1900helloword/HandBridge-SG90/Docs/PCB/BOM_Board1_PCB1_2026-09-20.xlsx

No. | Quantity | Comment | Designator | Footprint | Value | Manufacturer Part | Manufacturer | Supplier Part | Supplier
1 | 2 | 10uF | C1,C6 | C0603 | 10uF
2 | 1 | 106pF | C2 | C0603 | 106pF
3 | 1 | 104pF | C3 | C0603 | 104pF
4 | 1 | 223pF | C4 | C0603 | 223pF
5 | 1 | 105pF | C5 | C0603 | 105pF
6 | 1 | 220uF | C7 | C_Ele_SMD_3x5.4mm | 220uF
7 | 1 | 100nF | C8 | C0603 | 100nF
8 | 1 | 104pF | C25 | C0402 | 104pF
9 | 2 | 20pF | C33,C34 | C0805 | 20pF
10 | 3 | PH2.54-1X10P-H25 | H1,H2,H3 | HDR-TH_10P-P2.54-V-M |  | PH2.54-1X10P-H25 | JXTCONN(聚兴泰) | C42431810 | LCSC
11 | 1 | HDR-F_2.54_1x2P | H4 | HDR-TH_2P-P2.54-V-F |  |  |  | C49661
12 | 5 | PH2.54-1X3P-H25 | H5,H6,H7,H8,H9 | HDR-TH_3P-P2.54-V-M |  | PH2.54-1X3P-H25 | JXTCONN(聚兴泰) | C42431836 | LCSC
13 | 1 | LED_0603-B | LED1 | LED_0603
14 | 2 | LED_0603-R | LED2,LED3 | LED_0603
15 | 1 | LED_0603-G | LED4 | LED_0603
16 | 2 | S8050_SOT_NPN | Q1,Q2 | S8050_SOT-23
17 | 6 | 1K | R1,R2,R3,R10,R11,R12 | R0603 | 1K
18 | 20 | 10K | R4,R6,R7,R8,R9,R18,R24,R25,R26,R27,R28,R29,R30,R31,R32,R33,R34,R35,R36,R37 | R0603 | 10K
19 | 1 | 10K | R5 | R0402 | 10K
20 | 10 | 220 | R13,R14,R15,R16,R17,R19,R20,R21,R22,R23 | R0603 | 220
21 | 10 | 2.2 | R38,R39,R40,R41,R42,R43,R44,R45,R46,R47 | R0603 | 2.2
22 | 1 | BUTTON2,KEY | SW1 | KEY-SMD_L6.0-W3.5-LS8.0 |  | BUTTON2,KEY |  | C9900020455 | LCSC
23 | 1 | STM32F103C8T6 | U1 | LQFP-48_L7.0-W7.0-P0.50-LS9.0-BL |  | STM32F103C8T6 | ST(意法半导体) | C8734 | LCSC
24 | 1 | CH340C | U2 | SOP-16_L10.0-W3.9-P1.27-LS6.0-BL |  | CH340C | WCH(南京沁恒) | C84681 | LCSC
25 | 1 | RT9193-33GB | U3 | SOT-23-5_L3.0-W1.7-P0.95-LS2.8-BL |  | RT9193-33GB | RICHTEK(立锜) | C15651 | LCSC
26 | 1 | USB | U4 | USB-SMD_USB_1 |  | USB |  | C9900237861 | LCSC
27 | 1 | BZT52C5V1 | U5 | LL-34_L3.5-W1.5-RD-2 |  | BZT52C5V1 |  | C9900013832 | LCSC
28 | 1 | PCA9685PW/Q900,118 | U10 | TSSOP-28_L9.7-W4.4-P0.65-LS6.4-BL |  | PCA9685PW/Q900,118 | NXP(恩智浦) | C92206 | LCSC
29 | 1 | 8MHz | U18 | CRYSTAL-SMD_4P-L3.2-W2.5-BL | 8MHz | 3225-8.00-18-10-10/4B | LIMING(利明) | C7424754 | LCSC
