1900helloword/HandBridge-SG90/Core/Src/main.c

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
/* Includes ------------------------------------------------------------------*/
#include "main.h"
#include "adc.h"
#include "i2c.h"
#include "usart.h"
#include "gpio.h"

/* USER CODE BEGIN Includes */
#include <stdio.h>
#include <string.h>

#include "message.h"
#include "control.h"

#define MESSAGE_SIZE 64

char message_buffer[MESSAGE_SIZE] = {0};
control_t amazinghand_control;

/* USER CODE END Includes */


void SystemClock_Config(void);
/* USER CODE BEGIN 0 */
#if 1
int fputc(int ch, FILE *f)
{
  HAL_UART_Transmit(&huart1, (uint8_t *)&ch, 1, 0xffff);
  return ch;
}
#endif

void HAL_UART_RxCpltCallback(UART_HandleTypeDef *huart)
{
  if (huart == &huart3)
  {
    bll_message_get();
  }
}

/* USER CODE END 0 */

/**
  * @brief  The application entry point.
  * @retval int
  */
int main(void)
{

  /* MCU Configuration--------------------------------------------------------*/

  /* Reset of all peripherals, Initializes the Flash interface and the Systick. */
  HAL_Init();

  /* Configure the system clock */
  SystemClock_Config();

  /* Initialize all configured peripherals */
  MX_GPIO_Init();
  MX_USART1_UART_Init();
  MX_I2C1_Init();
  MX_ADC1_Init();
  MX_USART3_UART_Init();
  /* USER CODE BEGIN 2 */
#if 1
  printf("Software update date: 2026/9/20 14:01\n");
#endif

  amazinghand_control.huart = &huart3;
  amazinghand_control.hi2c = &hi2c1;
  amazinghand_control.hadc = &hadc1;

  if (bll_control_init(amazinghand_control) == 1)
  {
#if 1
    printf("Control initialization failed\n");
#endif
    HAL_NVIC_SystemReset();
  }

  if (bll_message_init(&huart3) == 1)
  {
#if 1
    printf("Message initialization failed\n");
#endif
    HAL_NVIC_SystemReset();
  }

  /* USER CODE END 2 */

  /* Infinite loop */
  /* USER CODE BEGIN WHILE */
  while (1)
  {
    /* USER CODE END WHILE */

    /* USER CODE BEGIN 3 */
    if (bll_message_relase(message_buffer, MESSAGE_SIZE) == 0)
    {
#if 1
      printf("Host : ");
      for (uint8_t i = 0; i < (6 + message_buffer[3] - 2); i++)
      {
        printf("%02X ", message_buffer[i]);
      }
      printf("\n");
#endif

      bll_control_hand((uint8_t *)message_buffer, MESSAGE_SIZE);
      memset(message_buffer, 0, MESSAGE_SIZE);
    }
  }
  /* USER CODE END 3 */
}

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
