1900helloword/HandBridge-SG90/Servo_Protocol_Conversion.ioc

Mcu.UserName=STM32F103C8Tx
PA0-WKUP.Signal=ADCx_IN0
PA1.Signal=ADCx_IN1
PA10.Signal=USART1_RX
PA12.GPIO_Label=GD25Q64_CS
PA12.Signal=GPIO_Output
PA13.Signal=SYS_JTMS-SWDIO
PA14.Signal=SYS_JTCK-SWCLK
PA2.Signal=ADCx_IN2
PA3.Signal=ADCx_IN3
PA4.Signal=ADCx_IN4
PA5.Signal=ADCx_IN5
PA6.Signal=ADCx_IN6
PA7.Signal=ADCx_IN7
PA9.Signal=USART1_TX
PB0.Signal=ADCx_IN8
PB1.Signal=ADCx_IN9
PB10.Signal=USART3_TX
PB11.Signal=USART3_RX
PB6.Signal=I2C1_SCL
PB7.Signal=I2C1_SDA
PD0-OSC_IN.Signal=RCC_OSC_IN
PD1-OSC_OUT.Signal=RCC_OSC_OUT
