1900helloword/HandBridge-SG90/(commit log)

2026-09-20 Add STM32 core headers
2026-09-20 Add STM32 core sources
2026-09-20 Add prototype photo
2026-09-20 Add PCB design and manufacturing files
    [BOM_Board1_PCB1_2026-09-20.xlsx, PickAndPlace_PCB1_2026_09_20.xlsx]
2026-09-20 Add PCA9685 and SG90 driver
2026-09-20 Add W25Qxx storage driver
2026-09-20 Add Keil device configuration
2026-09-20 Add STM32 CMSIS device license
2026-09-20 Add STM32 CMSIS device headers
2026-09-20 Add STM32 HAL license
2026-09-20 Add STM32 HAL headers
2026-09-20 Add STM32 HAL legacy header
2026-09-20 Add STM32 HAL sources
